vektordaya-mekatrika/load-bank-fan-controller/board/RD 0.0.2/load-bank-fan-controller/load-bank-fan-controller.step

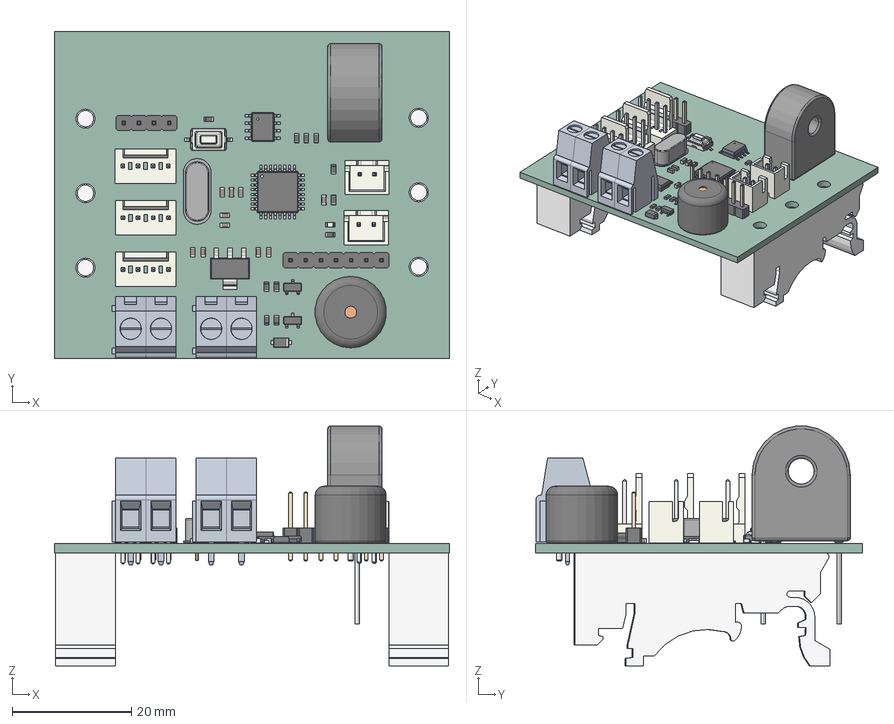
[picture p1: CAD file, 2024-09-26]
board/RD 0.0.2/load-bank-fan-controller/load-bank-fan-controller.step
66.3 x 54.8 x 40.2 mm
R_0603_1608Metric x 11
D_SOD_123F
PinHeader_1x07_P254mm_Vertical
SOT_223
C_0603_1608Metric x 10
KF128-5.08-2P x 2
Buzzer_12x95RM76
CQ assembly
TQFP_32_7x7mm_P08mm
SOT_23 x 2
Crystal_HC49-4H_Vertical
Molex_AE_6410_04A x 3
DINRailAdapter_3xM3_PhoenixContact_1201578 x 2
PE-51688NL
PTS636Sx25SMTRLFS
PinHeader_1x04_P254mm_Vertical
LED_0603_1608Metric
JST_B2B_XH_A x 2
load-bank-fan-controller_PCB
