vektordaya-mekatrika/load-bank-fan-controller/board/RD 0.0.2/load-bank-fan-controller/load-bank-fan-controller.kicad_pcb

## KiCad design board/RD 0.0.2/load-bank-fan-controller/load-bank-fan-controller.kicad_pcb (2024-10-17)

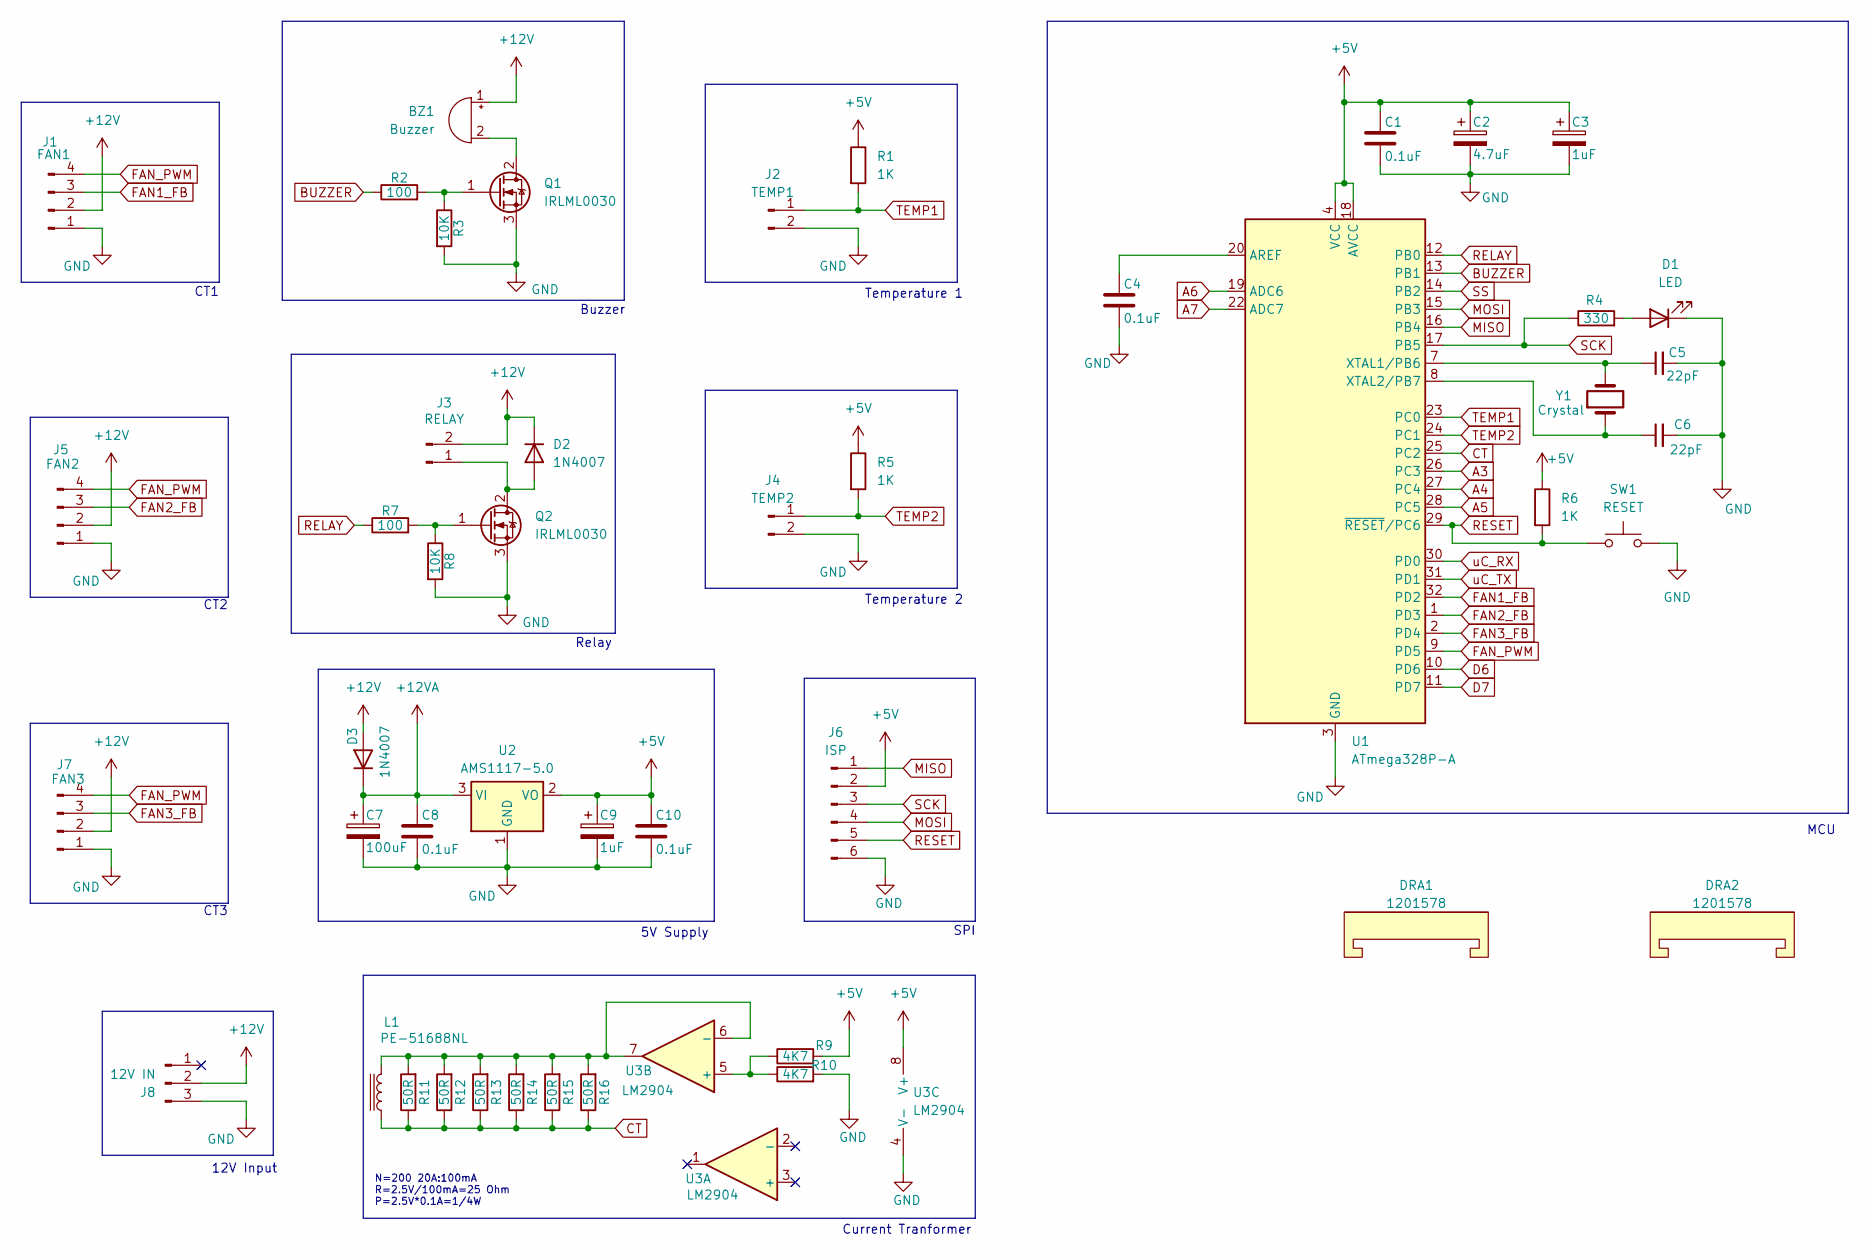
[picture p2: schematic load-bank-fan-controller.kicad_sch]

Parts:
BZ1: Buzzer; Buzzer_12x9.5RM7.6; Mfg PN TMB12A12; LCSC Part # DNP
C1, C4, C8, C10: 0.1uF; C_0603_1608Metric_Pad1.08x0.95mm_HandSolder; Mfg PN CC0603KRX7R8BB104; LCSC Part # C92490
C2: 4.7uF; C_0603_1608Metric_Pad1.08x0.95mm_HandSolder; Mfg PN CC0603KRX5R8BB475; LCSC Part # C326580
C3, C9: 1uF; C_0603_1608Metric_Pad1.08x0.95mm_HandSolder; Mfg PN CC0603KRX5R8BB105; LCSC Part # C14664
C5, C6: 22pF; C_0603_1608Metric_Pad1.08x0.95mm_HandSolder; Mfg PN CC0603JRNPO9BN220; LCSC Part # C105620
C7: 100uF; C_1210_3225Metric; Mfg PN EMK325ABJ107MM-T; LCSC Part # C394395
D1: LED; LED_0603_1608Metric_Pad1.05x0.95mm_HandSolder; Mfg PN LTST-C190GKT; LCSC Part # C125093
D2, D3: 1N4007; D_SOD-123F; Mfg PN 1N4007 A7; LCSC Part # C2902912
DRA1, DRA2: 1201578; DINRailAdapter_3xM3_PhoenixContact_1201578; Mfg PN 1201578; LCSC Part # C3019632
J1: FAN1; Molex_KK-254_AE-6410-04A_1x04_P2.54mm_Vertical; Mfg PN XD-2510-4A; LCSC Part # C17700994
J2: TEMP1; JST_XH_B2B-XH-A_1x02_P2.50mm_Vertical; Mfg PN ZX-XH2.54-2PZZ; LCSC Part # DNP
J3: RELAY; TerminalBlock_RND_205-00232_1x02_P5.08mm_Horizontal; Mfg PN WJ500V-5.08-2P; LCSC Part # C8465
J4: TEMP2; JST_XH_B2B-XH-A_1x02_P2.50mm_Vertical; Mfg PN ZX-XH2.54-2PZZ; LCSC Part # DNP
J5: FAN2; Molex_KK-254_AE-6410-04A_1x04_P2.54mm_Vertical; Mfg PN XD-2510-4A; LCSC Part # C17700994
J6: ISP; PinHeader_2x03_P2.54mm_Vertical; Mfg PN ZX-PZ2.54-2-3PZZ; LCSC Part # C7501274
J7: FAN3; Molex_KK-254_AE-6410-04A_1x04_P2.54mm_Vertical; Mfg PN XD-2510-4A; LCSC Part # DNP
J8: 12V IN; JST_VH_B3P-VH-B_1x03_P3.96mm_Vertical; Mfg PN HX VH3.96-3P ZZ; LCSC Part # C7435583
L1: PE-51688NL; PE51688NL; Mfg PN PE-51688NL; LCSC Part # C5718373
Q1, Q2: IRLML0030; SOT-23; Mfg PN IRLML0030TRPBF; LCSC Part # C67272
R1, R5, R6: 1K; R_0603_1608Metric_Pad0.98x0.95mm_HandSolder; Mfg PN RC0603FR-071KL; LCSC Part # C22548
R2, R7: 100; R_0603_1608Metric_Pad0.98x0.95mm_HandSolder; Mfg PN RC0603FR-07100RL; LCSC Part # C105588
R3, R8: 10K; R_0603_1608Metric_Pad0.98x0.95mm_HandSolder; Mfg PN RC0603FR-0710KL; LCSC Part # C98220
R4: 330; R_0603_1608Metric_Pad0.98x0.95mm_HandSolder; Mfg PN RC0603FR-07330RL; LCSC Part # C105881
R9, R10: 4K7; R_0603_1608Metric_Pad0.98x0.95mm_HandSolder; Mfg PN RC0603FR-074K7L; LCSC Part # C99782
R11, R12, R13, R14, R15, R16: 50R; R_MiniMELF_MMA-0204; Mfg PN CSR0204FTDV0500; LCSC Part # C489412
SW1: RESET; SW_Tactile_SPST_NO_Straight_CK_PTS636Sx25SMTRLFS; Mfg PN TS-1101-C-W; LCSC Part # C318938
U1: ATmega328P-A; TQFP-32_7x7mm_P0.8mm; Mfg PN ATmega328P-A; LCSC Part # C14877
U2: AMS1117-5.0; SOT-223-3_TabPin2; Mfg PN AMS1117-5.0; LCSC Part # C6187
U3: LM2904; SO-8_3.9x4.9mm_P1.27mm; Mfg PN LM2904DT; LCSC Part # C105411
Y1: Crystal; Crystal_HC49-U_Vertical; Mfg PN X49SD16MSD2SC; LCSC Part # C16212

Connections:
+5V: C1.1, C2.1, C3.1, C9.1, C10.1, J6.2, R1.1, R5.1, R6.1, R9.2, U1.4 (VCC), U1.6 (VCC), U1.18 (AVCC), U2.2 (VO), U3.8 (V+)
+12V: BZ1.1 (+), D2.1 (K), D3.2 (A), J1.2, J3.2, J5.2, J7.2, J8.2
+12VA: C7.1, C8.1, D3.1 (K), U2.3 (VI)
A3: U1.26 (PC3)
A4: U1.27 (PC4)
A5: U1.28 (PC5)
A6: U1.19 (ADC6)
A7: U1.22 (ADC7)
BUZZER: R2.1, U1.13 (PB1)
CT: L1.1, R11.1, R12.1, R13.1, R14.1, R15.1, R16.1, U1.25 (PC2)
D6: U1.10 (PD6)
D7: U1.11 (PD7)
FAN1_FB: J1.3, U1.32 (PD2)
FAN2_FB: J5.3, U1.1 (PD3)
FAN3_FB: J7.3, U1.2 (PD4)
FAN_PWM: J1.4, J5.4, J7.4, U1.9 (PD5)
GND: C1.2, C2.2, C3.2, C4.2, C5.2, C6.2, C7.2, C8.2, C9.2, C10.2, D1.1 (K), J1.1, J2.2, J4.2, J5.1, J6.6, J7.1, J8.3, Q1.3 (S), Q2.3 (S), R3.2, R8.2, R10.2, SW1.2, U1.3 (GND), U1.5 (GND), U1.21 (GND), U2.1 (GND), U3.4 (V-)
MISO: J6.1, U1.16 (PB4)
MOSI: J6.4, U1.15 (PB3)
unnamed: BZ1.2 (-), Q1.2 (D)
unnamed: D1.2 (A), R4.2
unnamed: D2.2 (A), J3.1, Q2.2 (D)
unnamed: Q1.1 (G), R2.2, R3.1
unnamed: Q2.1 (G), R7.2, R8.1
unnamed: C4.1, U1.20 (AREF)
unnamed: C5.1, U1.7 (XTAL1/PB6), Y1.2
unnamed: C6.1, U1.8 (XTAL2/PB7), Y1.1
unnamed: R9.1, R10.1, U3.5 (+)
unnamed: L1.2, R11.2, R12.2, R13.2, R14.2, R15.2, R16.2, U3.6 (-), U3.7
RELAY: R7.1, U1.12 (PB0)
RESET: J6.5, R6.2, SW1.1, U1.29 (~RESET/PC6)
SCK: J6.3, R4.1, U1.17 (PB5)
SS: U1.14 (PB2)
TEMP1: J2.1, R1.2, U1.23 (PC0)
TEMP2: J4.1, R5.2, U1.24 (PC1)
uC_RX: U1.30 (PD0)
uC_TX: U1.31 (PD1)

Notes on the sheet:
CT2
Current Tranformer
Temperature 1
12V Input
CT3
Buzzer
CT1
Relay
N=200 20A:100mA R=2.5V/100mA=25 Ohm P=2.5V*0.1A=1/4W
Temperature 2
5V Supply
SPI
MCU

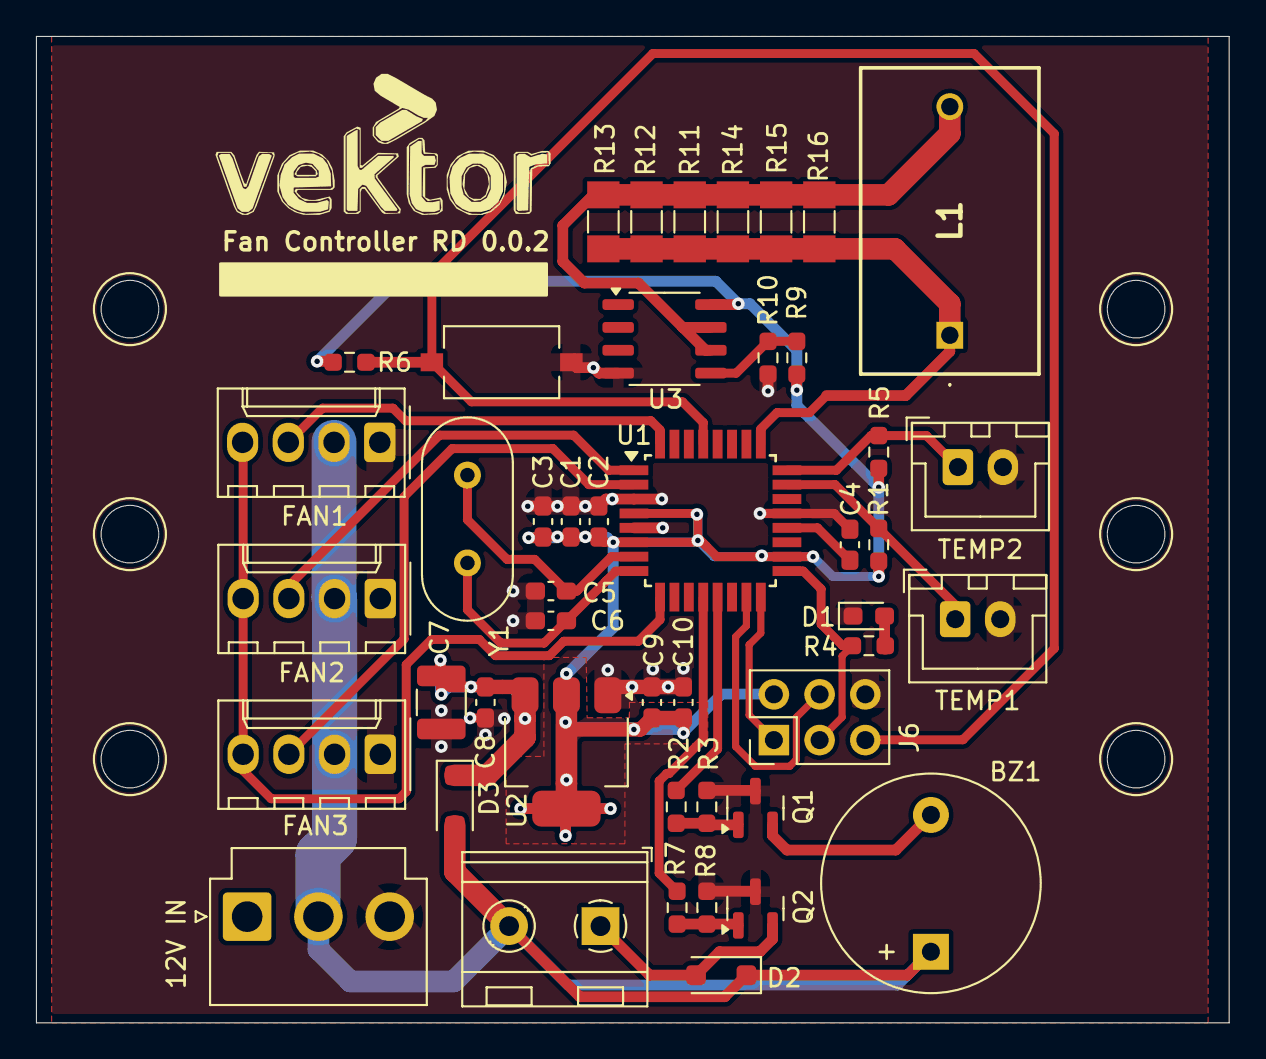
[picture p3: board board/RD 0.0.2/load-bank-fan-controller/load-bank-fan-controller.kica… from above]

Board: 2 copper layers, 66.3 x 54.8 mm, 48 parts (0 on the bottom side), 27 nets.
