vektordaya-mekatrika/load-bank-fan-controller/board/RD 0.0.1/load-bank-fan-controller/load-bank-fan-controller.kicad_pcb

## KiCad design board/RD 0.0.1/load-bank-fan-controller/load-bank-fan-controller.kicad_pcb (2024-09-25, an earlier design)

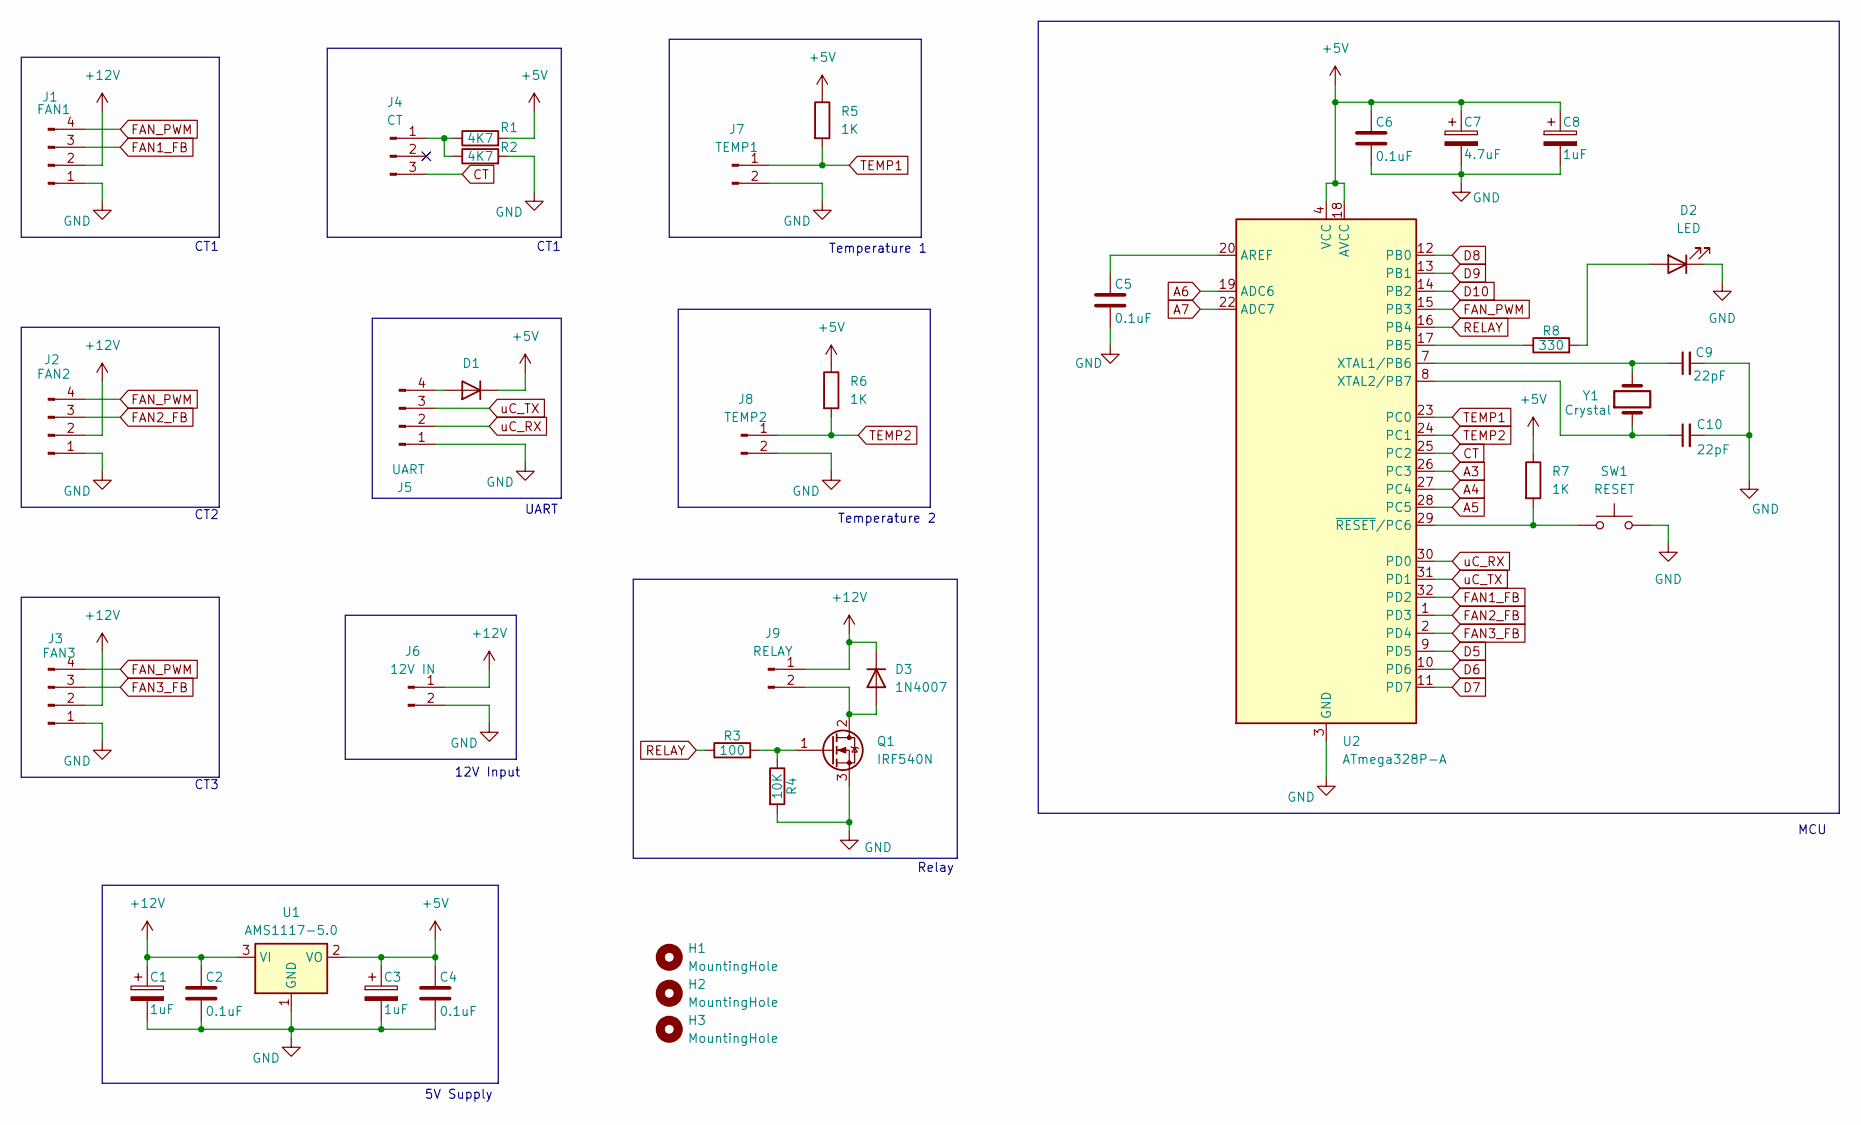
[picture p4: schematic load-bank-fan-controller.kicad_sch]

Parts:
C1, C3, C8: 1uF; C_0603_1608Metric_Pad1.08x0.95mm_HandSolder; Mfg PN CC0603KRX5R8BB105; LCSC Part # C14664
C2, C4, C5, C6: 0.1uF; C_0603_1608Metric_Pad1.08x0.95mm_HandSolder; Mfg PN CC0603KRX7R8BB104; LCSC Part # C92490
C7: 4.7uF; C_0603_1608Metric_Pad1.08x0.95mm_HandSolder; Mfg PN CC0603KRX5R8BB475; LCSC Part # C326580
C9, C10: 22pF; C_0603_1608Metric_Pad1.08x0.95mm_HandSolder; Mfg PN CC0603JRNPO9BN220; LCSC Part # C105620
D1: Safety Diode; D_SOD-523; Mfg PN RB521S30T1G; LCSC Part # C145179
D2: LED; LED_0603_1608Metric_Pad1.05x0.95mm_HandSolder; Mfg PN LTST-C190GKT; LCSC Part # C125093
D3: 1N4007; D_SOD-123F; Mfg PN 1N4007 A7; LCSC Part # C2902912
H1, H2, H3: MountingHole; MountingHole_3.2mm_M3
J1: FAN1; Molex_KK-254_AE-6410-04A_1x04_P2.54mm_Vertical; Mfg PN 470531000; LCSC Part # C240840
J2: FAN2; Molex_KK-254_AE-6410-04A_1x04_P2.54mm_Vertical; Mfg PN 470531000; LCSC Part # C240840
J3: FAN3; Molex_KK-254_AE-6410-04A_1x04_P2.54mm_Vertical; Mfg PN 470531000; LCSC Part # C240840
J4: CT; JST_XH_B3B-XH-A_1x03_P2.50mm_Vertical; Mfg PN ZX-XH2.54-3PZZ; LCSC Part # C7429633
J5: UART; JST_XH_B4B-XH-A_1x04_P2.50mm_Vertical; Mfg PN ZX-XH2.54-4PZZ; LCSC Part # C7429634
J6: 12V IN; TerminalBlock_RND_205-00232_1x02_P5.08mm_Horizontal; Mfg PN WJ500V-5.08-2P; LCSC Part # C8465
J7: TEMP1; JST_XH_B2B-XH-A_1x02_P2.50mm_Vertical; Mfg PN ZX-XH2.54-2PZZ; LCSC Part # C7429632
J8: TEMP2; JST_XH_B2B-XH-A_1x02_P2.50mm_Vertical; Mfg PN ZX-XH2.54-2PZZ; LCSC Part # C7429632
J9: RELAY; TerminalBlock_RND_205-00232_1x02_P5.08mm_Horizontal; Mfg PN WJ500V-5.08-2P; LCSC Part # C8465
Q1: IRF540N; TO-220-3_Horizontal_TabDown; Mfg PN IRF540NPBF; LCSC Part # C2566
R1, R2: 4K7; R_0603_1608Metric_Pad0.98x0.95mm_HandSolder; Mfg PN RC0603FR-074K7L; LCSC Part # C99782
R3: 100; R_0603_1608Metric_Pad0.98x0.95mm_HandSolder; Mfg PN RC0603FR-07100RL; LCSC Part # C105588
R4: 10K; R_0603_1608Metric_Pad0.98x0.95mm_HandSolder; Mfg PN RC0603FR-0710KL; LCSC Part # C98220
R5, R6, R7: 1K; R_0603_1608Metric_Pad0.98x0.95mm_HandSolder; Mfg PN RC0603FR-071KL; LCSC Part # C22548
R8: 330; R_0603_1608Metric_Pad0.98x0.95mm_HandSolder; Mfg PN RC0603FR-07330RL; LCSC Part # C105881
SW1: RESET; SW_Tactile_SPST_NO_Straight_CK_PTS636Sx25SMTRLFS; Mfg PN TS-1101-C-W; LCSC Part # C318938
U1: AMS1117-5.0; SOT-223-3_TabPin2; Mfg PN AMS1117-5.0; LCSC Part # C6187
U2: ATmega328P-A; TQFP-32_7x7mm_P0.8mm; Mfg PN ATmega328P-A; LCSC Part # C14877
Y1: Crystal; Crystal_HC49-U_Vertical; Mfg PN X49SD16MSD2SC; LCSC Part # C16212

Connections:
+5V: C3.1, C4.1, C6.1, C7.1, C8.1, D1.1 (K), R1.2, R5.1, R6.1, R7.1, U1.2 (VO), U2.4 (VCC), U2.6 (VCC), U2.18 (AVCC)
+12V: C1.1, C2.1, D3.1 (K), J1.2, J2.2, J3.2, J6.1, J9.1, U1.3 (VI)
A3: U2.26 (PC3)
A4: U2.27 (PC4)
A5: U2.28 (PC5)
A6: U2.19 (ADC6)
A7: U2.22 (ADC7)
CT: J4.3, U2.25 (PC2)
D5: U2.9 (PD5)
D6: U2.10 (PD6)
D7: U2.11 (PD7)
D8: U2.12 (PB0)
D9: U2.13 (PB1)
D10: U2.14 (PB2)
FAN1_FB: J1.3, U2.32 (PD2)
FAN2_FB: J2.3, U2.1 (PD3)
FAN3_FB: J3.3, U2.2 (PD4)
FAN_PWM: J1.4, J2.4, J3.4, U2.15 (PB3)
GND: C1.2, C2.2, C3.2, C4.2, C5.2, C6.2, C7.2, C8.2, C9.2, C10.2, D2.1 (K), J1.1, J2.1, J3.1, J5.1, J6.2, J7.2, J8.2, Q1.3 (S), R2.2, R4.2, SW1.2, U1.1 (GND), U2.3 (GND), U2.5 (GND), U2.21 (GND)
unnamed: D1.2 (A), J5.4
unnamed: D2.2 (A), R8.2
unnamed: D3.2 (A), J9.2, Q1.2 (D)
unnamed: J4.1, R1.1, R2.1
unnamed: Q1.1 (G), R3.2, R4.1
unnamed: C5.1, U2.20 (AREF)
unnamed: R8.1, U2.17 (PB5)
unnamed: C9.1, U2.7 (XTAL1/PB6), Y1.2
unnamed: C10.1, U2.8 (XTAL2/PB7), Y1.1
unnamed: R7.2, SW1.1, U2.29 (~RESET/PC6)
RELAY: R3.1, U2.16 (PB4)
TEMP1: J7.1, R5.2, U2.23 (PC0)
TEMP2: J8.1, R6.2, U2.24 (PC1)
uC_RX: J5.2, U2.30 (PD0)
uC_TX: J5.3, U2.31 (PD1)

Notes on the sheet:
CT2
CT1
Temperature 1
12V Input
CT3
UART
Relay
Temperature 2
5V Supply
MCU

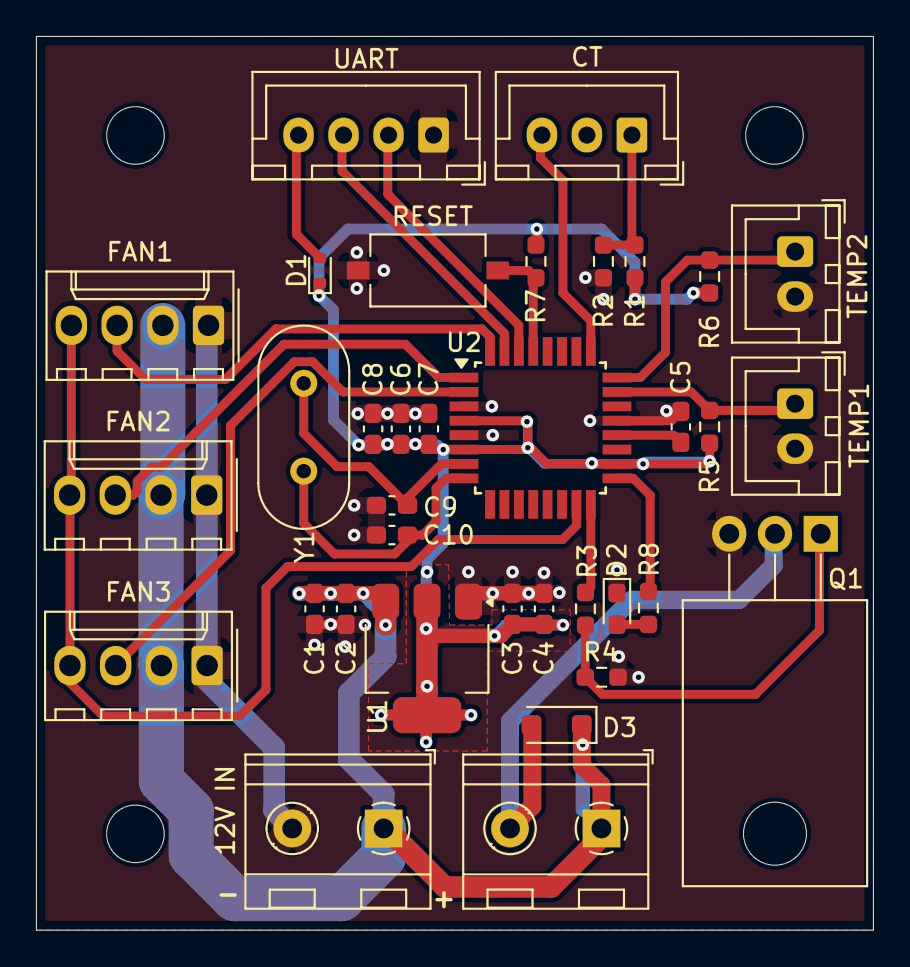
[picture p5: board board/RD 0.0.1/load-bank-fan-controller/load-bank-fan-controller.kica… from above]

Board: 2 copper layers, 46.5 x 49.7 mm, 38 parts (0 on the bottom side), 23 nets.
