vektordaya-mekatrika/load-bank-fan-controller/(commit log)

2024-09-13 finish board routing
    [load-bank-fan-controller.kicad_pcb, load-bank-fan-controller.kicad_sch]
2024-09-25 change pin assignment
    [bom.csv, designators.csv, load-bank-fan-controller.kicad_pcb, load-bank-fan-controller.kicad_sch, positions.csv]
2024-09-25 add code to reset rpm
    [load-bank-fan-controller.ino]
2024-09-25 add code for relay and tidy up the code
2024-09-25 move the files to deeper folder
    [bom.csv, designators.csv, load-bank-fan-controller.kicad_pcb, load-bank-fan-controller.kicad_sch, positions.csv]
2024-09-26 first commit for the RD 0.0.2
    add buzzer, spi conn, onboard CT, din rail mount adapter, change some conn and FET
    [bom.csv, designators.csv, load-bank-fan-controller.kicad_pcb, load-bank-fan-controller.kicad_sch, load-bank-fan-controller.step, positions.csv]
2024-09-26 minor editting
    [bom.csv, designators.csv, positions.csv]
2024-09-27 replace current sense resistor with the proper one
    [bom.csv, designators.csv, load-bank-fan-controller.kicad_pcb, load-bank-fan-controller.kicad_sch, positions.csv]
2024-09-27 connector changed and component added
    change 12v connector, change spi to icsp connector, change regulator input cap to 100u, remove uart conn, add diode to regulator input
    [bom.csv, designators.csv, load-bank-fan-controller.kicad_pcb, load-bank-fan-controller.kicad_sch, positions.csv]
2024-10-01 straighten the din rail mount
    [load-bank-fan-controller.kicad_pcb]
2024-10-14 update the production file, and reverse the relay ops in the code
    [positions.csv]
2024-10-17 change wrong footprint from L_1210 to C_1210
    [load-bank-fan-controller.kicad_pcb, load-bank-fan-controller.kicad_sch]
2024-11-08 edit pin assignment
